chipdipru/RDC2-0042-yearly-timer/RDC2-0041_KicadProject/RDC2-0041.pdf

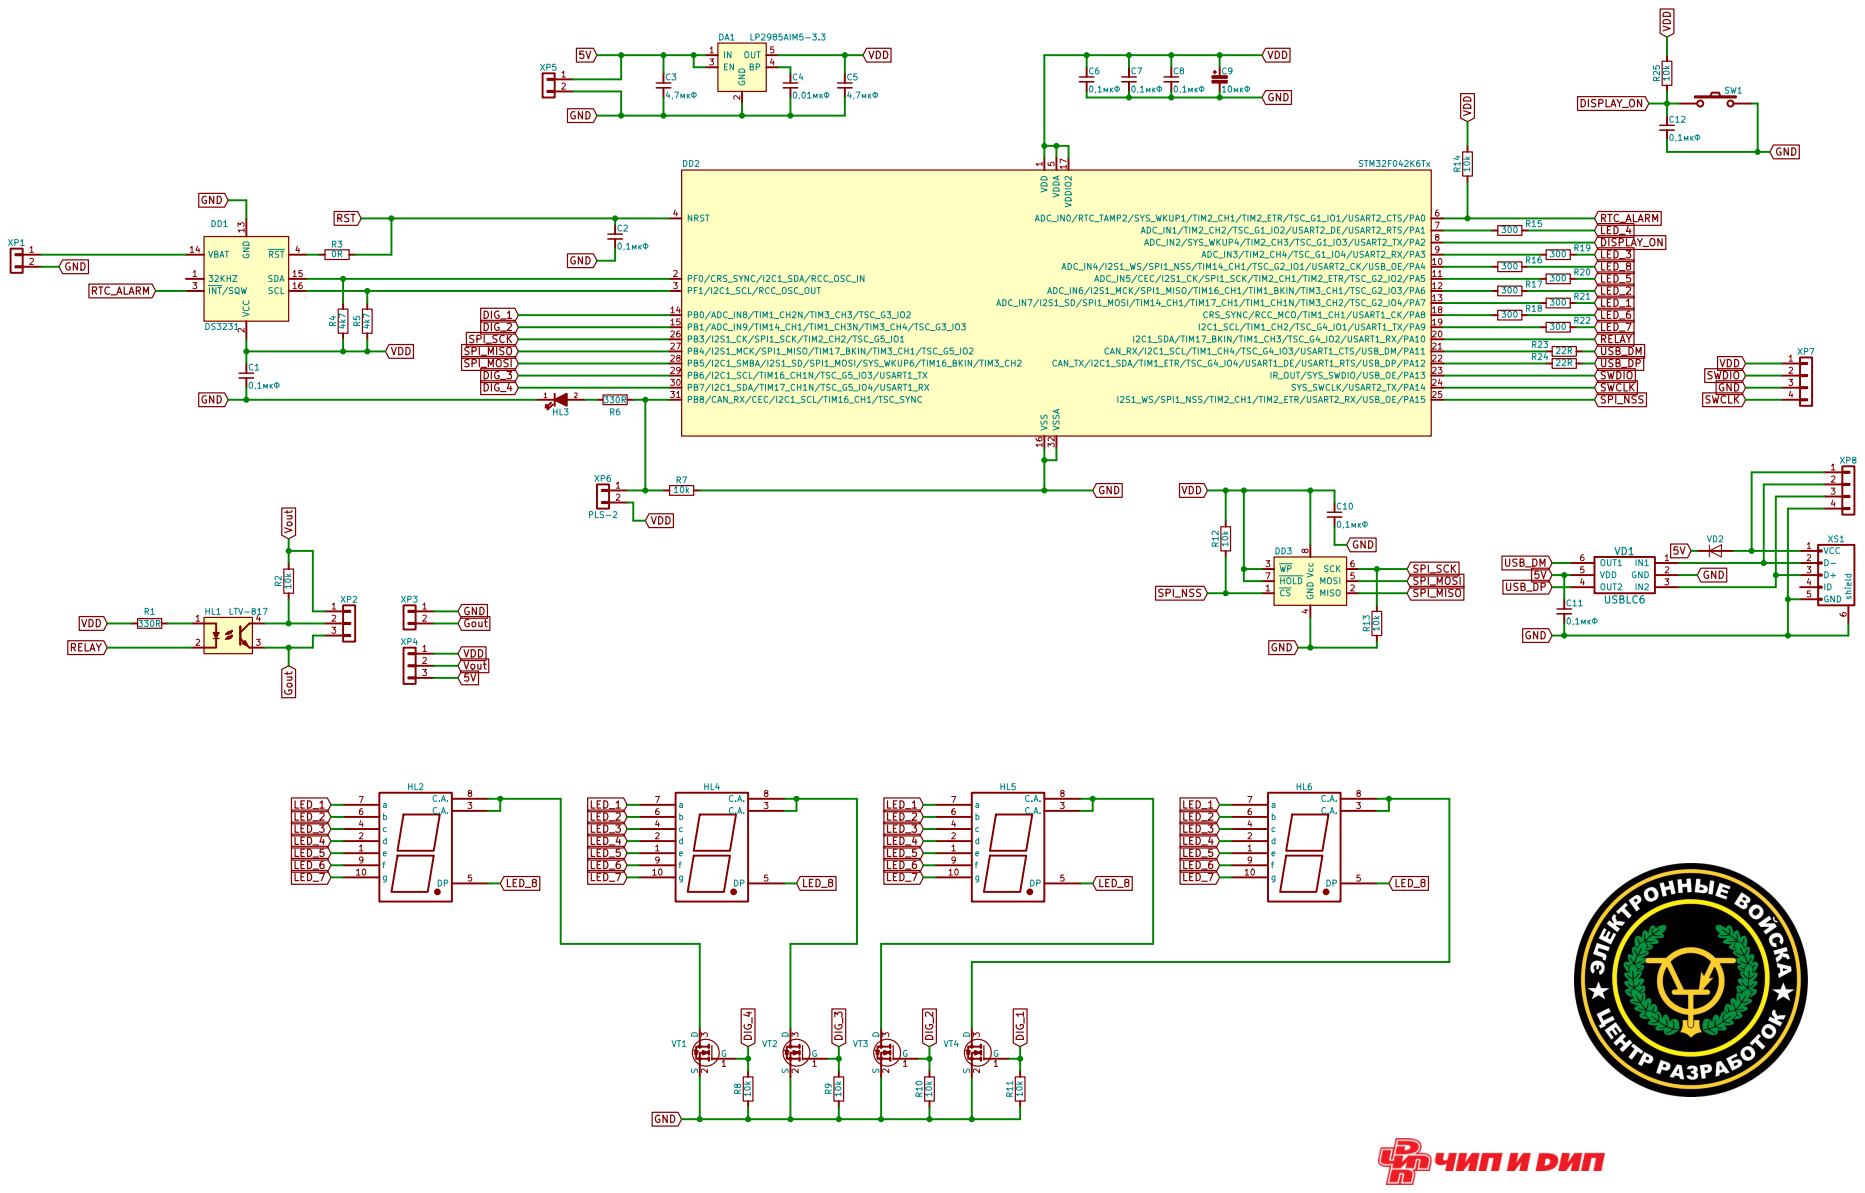
[picture p10: page 1]

2 EN 3 BP 4 OUT 5 DA1 LP2985AIM5-3.3 GND
10k GND

4 MOSI 5 SCK 6 HOLD 7 Vcc DD3 8GND
