chipdipru/RDC2-0042-yearly-timer/RDC2-0041_KicadProject/RDC2-0041.kicad_pcb

## KiCad design RDC2-0041_KicadProject/RDC2-0041.kicad_pcb (2018-10-02)

Schematic: RDC2-0041.sch

Parts:
C1, C2, C6, C7, C8, C10, C11, C12: 0,1мкФ; C_0603_HandSoldering
C3, C5: 4,7мкФ; C_0603_HandSoldering
C4: 0,01мкФ; C_0603_HandSoldering
C9: 10мкФ; TantalC_SizeA_EIA-3216_HandSoldering_mm
DA1: LP2985AIM5-3.3; SOT-23-5_mm
DD1: DS3231; SOIC-16_7.5x10.3mm_Pitch1.27mm
DD2: STM32F042K6Tx; LQFP-32_7x7mm_Pitch0.8mm
DD3: 25LC_EEPROM; SOIC-8_3.9x4.9mm_Pitch1.27mm
HL1: LTV-817; LTV817S
HL2, HL4, HL5, HL6: 7SEGMENTS; Oasistek_7SegInd_smd
HL3: LED; LED_0603_HandSoldering
R1, R6: 330R; R_0603_HandSoldering
R2, R7, R8, R9, R10, R11, R12, R13, R14, R25: 10k; R_0603_HandSoldering
R3: 0R; R_0603_HandSoldering
R4, R5: 4k7; R_0603_HandSoldering
R15, R16, R17, R18, R19, R20, R21, R22: 300; R_0603_HandSoldering
R23, R24: 22R; R_0603_HandSoldering
SW1: SW_PUSH; TC-0120
VD1: USBLC6; SOT23-6L
VD2: D; SOD-123
VT1, VT2, VT3, VT4: BSS138; SOT-23_mm
XP1: PLS-2; KLS5-CR1220-01
XP2: CONN_01X03; Clem_3Pos_P5
XP3, XP5, XP6: PLS-2; Pin_Header_Straight_1x02_mm
XP4: CONN_01X03; Pin_Header_Straight_1x03_mm
XP7: CONN_01X04; Pin_Header_Straight_1x04_mm
XP8: CONN_01X04; pin_header-4-1.5_pitch
XS1: USB_OTG; Micro_USB_ElecFreaks

Connections:
5V: C3.1, C11.1, DA1.1 (IN), DA1.3 (EN), VD1.5 (VDD), VD2.1, XP4.3, XP5.1
DIG_1: DD2.14, R11.2, VT4.1
DIG_2: DD2.15, R10.2, VT3.1
DIG_3: DD2.29, R9.2, VT2.1
DIG_4: DD2.30, R8.2, VT1.1
DISPLAY_ON: C12.1, DD2.8, R25.1, SW1.1
GND: C1.2, C2.2, C3.2, C4.2, C5.2, C6.2, C7.2, C8.2, C9.2, C10.2, C11.2, C12.2, DA1.2 (GND), DD1.5, DD1.6, DD1.7, DD1.8, DD1.9, DD1.10, DD1.11, DD1.12, DD1.13, DD2.16, DD2.32, DD3.4, HL3.1 (K), R7.2, R8.1, R9.1, R10.1, R11.1, R13.1, SW1.2, VD1.2 (GND), VT1.2, VT2.2, VT3.2, VT4.2, XP1.2, XP3.1, XP5.2, XP7.3, XP8.4, XS1.5 (GND), XS1.6 (shield)
Gout: HL1.3, XP2.3, XP3.2
LED_1: HL2.7, HL4.7, HL5.7, HL6.7, R21.2
LED_2: HL2.6, HL4.6, HL5.6, HL6.6, R17.2
LED_3: HL2.4, HL4.4, HL5.4, HL6.4, R19.2
LED_4: HL2.2, HL4.2, HL5.2, HL6.2, R15.2
LED_5: HL2.1, HL4.1, HL5.1, HL6.1, R20.2
LED_6: HL2.9, HL4.9, HL5.9, HL6.9, R18.2
LED_7: HL2.10, HL4.10, HL5.10, HL6.10, R22.2
LED_8: HL2.5, HL4.5, HL5.5, HL6.5, R16.2
unnamed: C4.1, DA1.4 (BP)
unnamed: DD1.4, R3.2
unnamed: DD1.14, XP1.1
unnamed: DD1.15, DD2.2, R4.2
unnamed: DD1.16, DD2.3, R5.2
unnamed: DD2.7, R15.1
unnamed: DD2.9, R19.1
unnamed: DD2.10, R16.1
unnamed: DD2.11, R20.1
unnamed: DD2.12, R17.1
unnamed: DD2.13, R21.1
unnamed: DD2.18, R18.1
unnamed: DD2.19, R22.1
unnamed: DD2.21, R23.1
unnamed: DD2.22, R24.1
unnamed: DD2.31, R6.1, R7.1, XP6.1
unnamed: HL1.1, R1.2
unnamed: HL1.4, R2.1, XP2.2
unnamed: HL2.3, HL2.8, VT1.3
unnamed: HL3.2 (A), R6.2
unnamed: HL4.3, HL4.8, VT2.3
unnamed: HL5.3, HL5.8, VT3.3
unnamed: HL6.3, HL6.8, VT4.3
unnamed: VD1.1 (IN1), XP8.2, XS1.2 (D-)
unnamed: VD1.3 (IN2), XP8.3, XS1.3 (D+)
unnamed: VD2.2, XP8.1, XS1.1 (VCC)
RELAY: DD2.20, HL1.2
RST: C2.1, DD2.4, R3.1
RTC_ALARM: DD1.3, DD2.6, R14.1
SPI_MISO: DD2.27, DD3.2
SPI_MOSI: DD2.28, DD3.5
SPI_NSS: DD2.25, DD3.1, R12.1
SPI_SCK: DD2.26, DD3.6, R13.2
SWCLK: DD2.24, XP7.4
SWDIO: DD2.23, XP7.2
USB_DM: R23.2, VD1.6 (OUT1)
USB_DP: R24.2, VD1.4 (OUT2)
VDD: C1.1, C5.1, C6.1, C7.1, C8.1, C9.1, C10.1, DA1.5 (OUT), DD1.2, DD2.1, DD2.5, DD2.17, DD3.3, DD3.7, DD3.8, R1.1, R4.1, R5.1, R12.2, R14.2, R25.2, XP4.1, XP6.2, XP7.1
Vout: R2.2, XP2.1, XP4.2

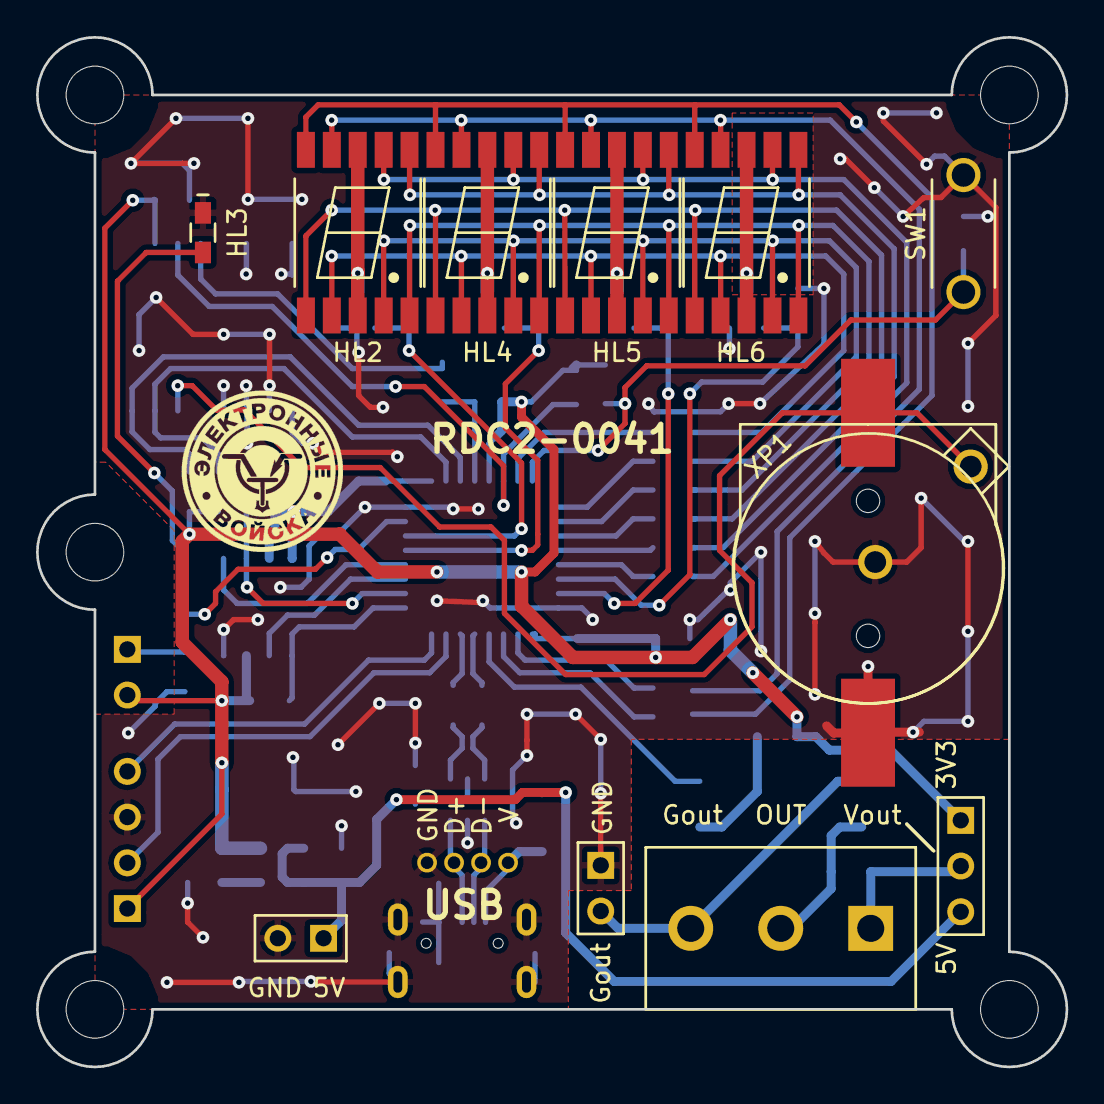
[picture p11: board RDC2-0041.kicad_pcb from above]

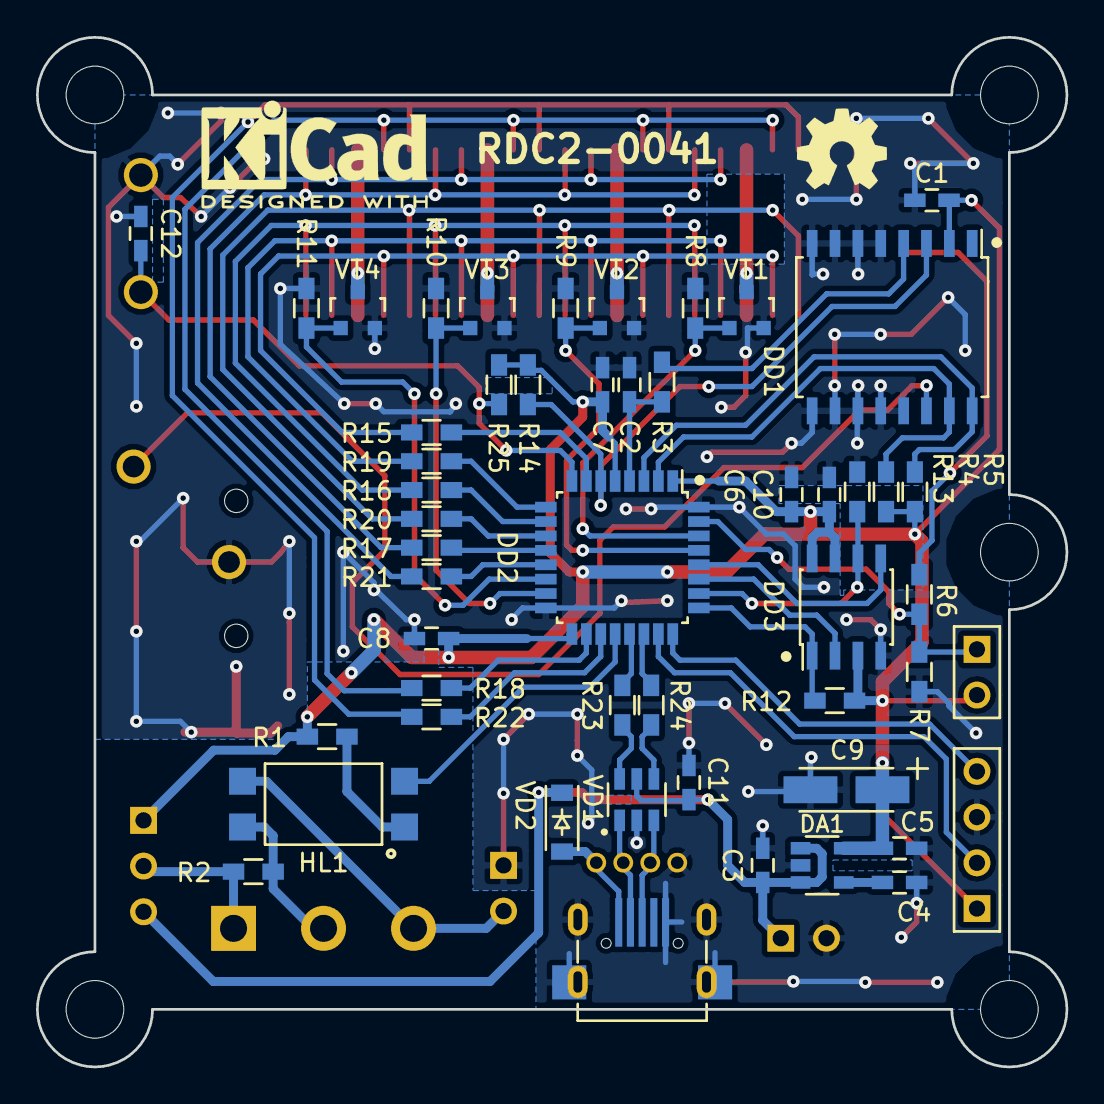
[picture p12: board RDC2-0041.kicad_pcb from below]

Board: 2 copper layers, 57.2 x 57.2 mm, 63 parts (52 on the bottom side), 55 nets.
