chipdipru/RDC2-0042-yearly-timer/(commit log)

2018-10-02 Прошивка DFU
2018-10-02 soft для настроек
2018-10-02 KiCad project
    [RDC2-0041-2018-09-04-16-28-28.sch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]
2018-10-02 инструкция описание
