chipdipru/RDC2-0042-yearly-timer/(notices)

Notices in the files:
RDC2-0041_year/Scr/SPI_EEPROM.c:
COPYRIGHT(c) ÇÀÎ «×ÈÏ è ÄÈÏ», 2018
RDC2-0041_year/Scr/I2C.c:
COPYRIGHT(c) ÇÀÎ «×ÈÏ è ÄÈÏ», 2017, 2018
RDC2-0041_year/Inc/RDC2_0041_USB.h:
COPYRIGHT(c) ÇÀÎ «×ÈÏ è ÄÈÏ», 2017
